christofteuscher/tt-eml-fabric/spice/cell/v3/v3_tran_results.txt

-0.5u 9.37857E-07 9.37859E-07 9.37855E-07
0.5u 5.20401E-07 5.20402E-07 5.204E-07
15u -6.56364E-07 -6.56362E-07 -6.56365E-07
