christofteuscher/tt-eml-fabric/(commit log)

2026-07-30 EML Fabric: analog config + datasheet + cfgdig hardening CI
    Overlays the real project onto the ttsky26c analog template:
    info.yaml 2x2 tile, 3 analog pins, uses_vapwr, top_module
    tt_um_teuscher_eml_fabric; pinout = scan (ui0/1, uo0) +
    ua0 x_in / ua1 mux_out / ua2 iref_in
    docs/info.md datasheet written from measured behaviour
    src/ the wrapper (4 lv->hv scan shifters + macro) and cfgdig RTL
    openlane/cfgdig + .github/workflows/cfgdig.yaml
    LibreLane hardening of the 64-bit config chain -- the extra
    CI job; recipe proven locally over 15 Docker runs (hvl
    corners, PDN, core-area, pin-order, cell-pa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
    [pin_order.cfg]
2026-07-30 Remove pin_order.cfg: it breaks the cfgdig CI harden
    The cfgdig hardening job failed because LibreLane AUTO-RESOLVES a
    pin_order.cfg in the design dir even when IO_PIN_ORDER_CFG is unset, and
    this file's leading '#' comment lines are parsed as malformed side
    directives ("identifier/regex '#' requires a direction to be set first").
    There is no comment syntax in that format. config.json sets
    IO_PIN_ORDER_CFG=None and does not need it, so the file is removed. The
    local 251x36 recipe hardens clean without it.
    [pin_order.cfg]
2026-07-30 Pin cfgdig CI to LibreLane 3.0.5
    The harden ran the full flow (~10 min) then failed: 'nix run
    github:librelane/librelane' was UNPINNED, pulling newer than the 3.0.5
    the config recipe was tuned against over 15 local runs (corner names,
    FP_PDN_MULTILAYER, CELL_PAD_EXCLUDE, MAGIC_CAPTURE_ERRORS, etc. -- all
    3.0.5-specific). 3.1.0.dev builds exist upstream, so unpinned drifted
    ahead. Pinned to the exact local version.
    EOF
2026-07-30 cfgdig CI: ship hvl excluded-cell lists, override the broken PDK default
    With tools now pulled prebuilt from the FOSSI cache, the flow reaches
    PDK load and dies on SYNTH_EXCLUDED_CELL_FILE / PNR_EXCLUDED_CELL_FILE:
    LibreLane 3.0.5 defaults them to libs.tech/librelane/sky130_fd_sc_hvl/
    {synth,pnr}_excluded.cells, but ciel's default PDK rev (8afc834...)
    predates the hvl migration from libs.tech/openlane/no_synth.cells and
    ships neither -> 'path provided is invalid'. hd migrated; hvl did not.
    Ship both lists in the repo (content copied verbatim from the rev the
    local --dockerized runs use, f3c505b) and point the two variables at
    them via dir::, so signoff no longer depends on which PDK rev CI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
2026-07-30 cfgdig CI: patch the missing hvl exclude files into the fetched PDK
    The previous dir:: override was moot: SYNTH_EXCLUDED_CELL_FILE and
    PNR_EXCLUDED_CELL_FILE are validated at PDK-load, against the PDK's own
    declared paths (libs.tech/openlane/sky130_fd_sc_hvl/{no_synth,drc_exclude}
    .cells), which a design-config value cannot reach. Those two files exist
    in the local ~/.ciel tree but ciel's fresh fetch of the pinned rev omits
    them, so PDK load quits before the flow starts.
    Split harden into fetch + repair + harden: the fetch run downloads the
    whole PDK (then fails load, swallowed by || true), the repair step writes
    the two files verbatim into the fetched tree, and harden then loads the
    PDK cl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
2026-07-30 cfgdig CI: restore pin_order.cfg (the docker15 golden input)
    PDK load now clears (hvl excludes patched); the next PDK-load path error
    is IO_PIN_ORDER_CFG -> dir::pin_order.cfg, a file the config referenced
    but the repo lacked. An earlier precautionary removal left the dangling
    reference; CI never actually reached pin-order parsing back then because
    the nix tool build was failing first.
    Restore the exact side assignment the golden docker15 run used (which
    hardened to DRC 0 / LVS MATCH): all fabric-facing config lines South,
    the scan interface North. Descriptive header comments are dropped so the
    file is only directives + escaped-bracket regexes (parser-safe); key
    modernized FP_PIN_ORDER_CFG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
    [pin_order.cfg]
2026-08-06 Add the hardened analog macro; scan_clk moves to ui_in[2]
    GDS + LEF for tt_um_teuscher_eml_fabric, verified on exactly the files
    committed here:
    DRC 0 (sky130A_mr, feol+beol+offgrid), met5 and via4 empty, top cell
    renamed, bbox 0,0..319.24,225.76, LEF SIZE matches the TT DIEAREA.
    The macro is a rename+label of the routed top level -- geometry compared
    layer by layer, all 12 identical in shape count and area, so its LVS
    MATCH carries over.
    Routing: 52/62 nets, 5/5 signal pads, power 21/21, top LVS MATCH.
    Every functional net is connected -- the A->B chain (CELLA.out ->
    link1.glue.nout), all three analog bias rails (sum_Bv, vg4, vgu) and the
    full config scan chain. The 10 remaining opens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
2026-08-06 Fix precheck: full LEF port list, pins on real metal, iref to ua[1]
    Addresses three of the five precheck failures from run 31127339246.
    LEF PIN CHECK (was: 45 errors). gen_ttmacro.py emitted only the 6 pins
    this design uses; TT wants the whole template port list present so the
    harness can bind to it. It now parses tt_analog_2x2_3v3.def and emits
    all 54 -- clk, ena, ui_in[0..7], uio_in/out/oe, uo_out[0..7], ua[0..7],
    rst_n and the 3 power pins.
    PIN LABEL OVERLAPPING DRAWING (was: 4). Two separate causes:
    * the north pad boxes span y224.76-225.76 but the router draws met4
    only to y225.00, so 0.76 um of each pin rect lay over nothing. met4
    drawing is now laid across the full pad bo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
2026-08-06 Power ports: one full-height rect per stripe, not a decomposition
    Precheck on 30b0d12 went 10/15 -> 12/15 (pin-label-overlap and the
    analog pin now pass, LEF pin errors 45 -> 6), but the remaining 6 were
    all mine:
    ERROR: Port VAPWR is too far from bottom edge of module: 82.7 > 10 um
    ERROR: Port VAPWR is too far from top edge of module: 139.46 > 10 um (x3 pairs)
    TT wants a power port to start within 10 um of the bottom edge and reach
    within 10 um of the top. Clipping the stripe to real metal and then
    DECOMPOSING it into 11 rectangles produced mid-die fragments touching
    neither edge -- the previous commit fixed pin-label-overlap and broke
    power-port geometry in the same stroke.
    The s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
2026-08-06 Resistor precision marker on the body only; re-verified with TT's own deck
    VERIFIED LOCALLY BEFORE PUSHING, with the deck TT actually runs. That is
    new: silicon/tools/ttdeck now vendors tt-support-tools' precheck deck
    (release 2025.10.29_01.10, from chipfoundry/mpw_precheck, 1773 lines)
    alongside TT's exact PDK. The PDK's own deck is 2024.2.11_01.09 and 1629
    lines -- running it and calling the result "DRC clean" is what let this
    project report DRC 0 for weeks while precheck found 6 violations.
    tools/ttdrc.sh reproduces the CI number exactly.
    top: 52/62 nets, 5/5 signal pads, DRC 0, LVS MATCH
    TT deck on the submitted macro: feol 6, beol 0, offgrid 0
    THE RESISTOR CHANGE DOES NOT REDUC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
2026-08-07 Revert the resistor rpm change: Magic measured it 626 errors WORSE
    The previous commit moved the precision-resistor marker to the body only.
    KLayout scored that neutral -- 6 FEOL violations either way -- so it went
    out. Magic disagrees, and Magic is also part of precheck:
    30b0d12 (before) 3263 magic errors
    09ad48a (after) 3889 magic errors +626
    Heads left outside rpm abut its boundary at zero distance, and rpm.3 /
    rpm.7 want 0.4 um: +684 and +152, plus 304 rpm.1 and 228 poly.9, against
    ~800 licon ones removed. KLayout's deck does not implement rpm.3, rpm.7,
    poly.9, LU.2/LU.3, nwell.7/8 or capm.11 AT ALL, so tools/ttdrc.sh could
    never have caught this. Reverted; verified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
2026-08-07 Resistor cells + well/tap: Magic 3263 -> 214, KLayout FEOL 6 -> 0
    Measured locally before pushing, with both decks TT actually runs
    (silicon/tools/ttdrc.sh and ttmagic.sh, release 2025.10.29_01.10):
    MAGIC 3263 -> 214 KLAYOUT feol 6 -> 0
    toplevel_routed DRC 0, LVS MATCH, 0 shorts
    ROUTED 52/62, PAD ACCESS 5/5 -- unchanged by any of this
    Gone entirely: all 1034 licon errors, all 288 P+ poly.1a, all 67 LU.3,
    all 46 nwell.8, and the 6 MR_licon.CON.xx that were failing FEOL.
    The previous two attempts at the resistors both failed because they
    changed the cell without paying for it in the blocks. This one does
    both. Root causes, read out of the Magic tech file and the PDK P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
2026-08-07 hvi.5 mechanism found: decaps instead of fillers; Magic 192 -> 60
    Measured locally before pushing, both decks TT actually runs:
    MAGIC 192 -> 60 KLAYOUT feol 0
    toplevel_routed DRC 0, LVS MATCH ROUTED 52/62, PAD ACCESS 5/5
    The hvi.5 wall (161 of the 192) is broken. It was never a spacing
    problem in our drawn geometry: with `gds maskhints yes`, Magic re-derives
    thick oxide from DEVICES at GDS read and keeps only the un-derivable
    remainder of the drawn HVI as "mask hint" fragments -- hvi.5 is
    cifspacing over those fragments, not over the drawn layer. The fragments
    were runs of fill_* cells, which carry HVI but no diffusion; each run's
    HVI survived as a ~40 um hint strip, an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
2026-08-07 mdac_gamma LU.2 fixed; every analog block now Magic 0. Macro 60 -> 48
    MAGIC 60 -> 48 KLAYOUT feol 0
    Every analog block -- bias_core, rptat_trim, refchain, emlcell2,
    chainglue, raildrv, mdac2_alpha_d2, mdac2_gamma_d2 -- is now
    Magic 0 / KLayout 0 / LVS MATCH.
    mdac_gamma's 12 LU.2 had been parked as "the substrate tap breaks LVS"
    after five failed placements. The placements were never the problem: a
    bbox bug in the tap-fill helper. A leg riser's met1 tip pokes 0.05 um
    into the tap band, the free region was correctly notched around it, and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
2026-08-12 Submit the lvshift macro: Magic 0 on the SHIPPED file, 3 analog pins
    Layout, measured on one clean build (silicon 1a42bf8, EXTERNAL_LVSHIFT=1):
    ROUTED 57 / 57
    chk_padaccess 7 CONNECTED, 0 OPEN
    chk_conn 57 nets joined, 0 OPEN
    KLayout top DRC 0
    top LVS MATCH, 16 / 16 circuits
    MAGIC (assembly) 0
    And on the artifact in this commit, which is the one TT prechecks:
    tt_um_teuscher_eml_fabric.gds MAGIC 0, KLayout DRC 0
    tt_um_teuscher_eml_fabric.lef 54 pins, unchanged
    The four PDK level shifters are gone, replaced by the custom all-MV
    lvshift block (five-corner verified), which is what takes Magic to 0.
    The scan nets reach it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
2026-08-12 Restore all template ports; clear met4 spacing by trimming our own wire
    Fixes the precheck failure on 48bd0d0: "Port uo_out[7] missing from layer
    met4.pin", 44 GDS errors. Precheck reads the GDS pin layer, not just the
    LEF, so the previous drop of unused-pin geometry was the wrong trade -- it
    cured 8 met4.2 by removing 44 ports.
    Every template port is drawn again. The met4 spacing clash is resolved by
    trimming the routed wire end 0.08 um at packaging time:
    route ...81.050 -> ...80.970 against the pin box at 81.270
    gap 0.220 -> 0.300, exactly met4.2's minimum
    Verified on this file: Magic 0, KLayout DRC 0, 60 met4.pin shapes, LEF 54
    pins. TT's gds job already passed on the previo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
2026-08-12 Observability: every stage boundary of the chain reaches a pad
    The 2-cell chain was a black box: only the final output was visible, so a
    wrong answer could be CELLA, the gamma coupling or CELLB with nothing to
    tell them apart. The obs mux meant to solve this observed nothing and was
    cut. These are direct taps, like ua[0]/ua[2] already were.
    x_in ──> [CELLA] ──> out_CELLA ──> [gamma] ──> sum_Bv ──> [CELLB] ──> out_CELLB
    ua[3] ua[4] ua[0] ua[2]
    PADS ARE ASSIGNED BY GEOMETRY, NOT PIN NUMBER. The ua pads march west with
    index (ua[0] x=136.62 ... ua[5] x=40.02) while the consumers do not: CELLA
    sits west, CEL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
    [cfgdig.v]
2026-08-12 trim3 removed: the RTL allocated a 4th trim bit the network cannot use
    cfgdig.v declared rtrim[3:0] while rptat_trim has THREE shorting switches,
    so trim3 was a config bit that reached nothing. It surfaced only as an
    OPEN pin ("each is a pin the netlist gives no net") -- DRC, LVS and the
    conductance walk were all clean around it, because a bit that drives
    nothing shorts nothing.
    THE LAYOUT IS THE CORRECT SIDE. bias/rptat_trim.inc is three binary
    segments (1x/2x/4x the 5k unit) over a 15k base:
    R = 15k + (1-t0)*5k + (1-t1)*10k + (1-t2)*20k
    "Eight levels in 5k steps ... coarse ON PURPOSE: this is a range-setter,
    not a precision knob", and its 15-50k span already covers the measured
    po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
    [cfgdig.v]
2026-08-12 docs: the bringup guide described a chip that no longer exists
    info.md would have sent someone to the wrong pads. Every one of these
    was stale, and the pin errors are the kind you only discover with a
    probe on the bench:
    scan chain 64 bits -> 29. Weights are [24:0] (five, not eleven),
    trim is [27:25] (not [61:58]), tail [28].
    x_in ua[0] -> ua[3].
    scan_clk ui[1] -> ui[2]. ui[1] sits off the analog macro's 0.6 um
    routing grid so no via can be placed beside it -- this one
    has been true for a while and was never written down.
    obs mux documented with 8 channels and a mux_out on ua[1]; the
    block was removed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
2026-08-12 docs: quantify the weight monotonicity margin (70 MC samples)
    The monotonicity note previously cited 30 samples. Extended to 70:
    0/70 non-monotonic, per-sample worst DNL mean -0.276 sigma 0.190 LSB,
    worst observed -0.981 against the -1.0 limit.
    Stated the limit as ~3.8 sigma AND why that number should not be read as
    1-in-14000: -0.981 appeared once in 70 samples where a clean Gaussian at
    that sigma puts it near 1 in 3800, so the tail is heavier than normal and
    the Gaussian extrapolation understates the risk. 70 samples cannot
    resolve a 1e-4 tail in either direction. What is established: no sample
    was non-monotonic, and the margin is real but not large.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
2026-08-13 docs: record the measured ln deficit -- the chip computes exp(u) - 0.34*ln(v)
    Measured 2026-08-12, the first v-sweep in the project. The
    characterisation always held v=1, which zeroes the ln term, so this was
    never visible.
    ideal -1.000
    schematic -0.696 idealised OTAs, perfect bias
    silicon -0.342
    Root cause is servo gain: nva should be pinned to vrefb and drifts ~17 mV,
    so most of the transdiode differential that should drive R_LN shows up as
    servo input error instead. DESIGN-LEVEL, not layout or process -- the
    schematic with ideal sources is already 30% short, so a single 5T stage
    never had the gain a translinear loop needs.
    The exp path is unaffected and beh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
2026-08-13 Correct the exp path: resistors were sized without end resistance
    The poly resistors were sized by L/W x rsheet, which ignores END
    RESISTANCE -- effective sheet is 393 ohm/sq against a nominal 317.4, so
    res_5k measured +37% and res_13k45 +27%. RU/RLN are 4x res_13k45, which
    made the cell compute exp(1.23*u) instead of exp(u).
    Measured on the layout-matched netlist: exponent k 1.224 -> 0.961.
    Verified on THIS macro: 57/57 routed, pad access 9/9, power 23/23,
    top DRC 0, top LVS MATCH, Magic 0, 60 met4.pin shapes, and the resistor
    markers in the assembled GDS read 3.79 / 11.44 / 17.5 (were 5.47 / 14.72
    / 17.5).
    A second bug surfaced during the rebuild and is also fixed: a hardcoded
    copy of t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
2026-08-13 Back to 3 analog pins -- only 3 were purchased
    analog_pins was raised 3 -> 5 on 2026-08-12 to add observability taps on
    out_CELLA and sum_Bv. The TT template says "valid values 0 to 6" and I
    treated that as permission; only THREE were bought for this shuttle, so
    5 is not submittable.
    PRECHECK DID NOT CATCH IT. a4a231d passed CI including precheck, because
    precheck validates that DECLARED pins are CONNECTED -- not that you own
    them. A green check that did not mean what it appeared to.
    Reverted to the pre-observability arrangement, which is also the one whose
    routing is proven (it shipped as 9d37a59):
    ua[0] x_in | ua[1] iref | ua[2] out_CELLB
    TT wires ua[0..analog_pins-1], so the used pi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
2026-08-13 docs: add a block diagram and the source paper reference
    Diagram shows the actual signal path -- x_in -> CELL A -> glue -> gamma
    MDAC -> CELL B -> out_CELLB -- with the bias core, the trim network and
    the scan chain feeding the five weights, and the pin each edge lands on.
    Reference is the real citation, taken from the PDF rather than
    reconstructed: A. Odrzywolek, "All elementary functions from a single
    operator", Jagiellonian University, arXiv:2603.21852v2 [cs.SC],
    4 Apr 2026. Includes the operator definition, two of the papers own
    constructions (e^x = eml(x,1), ln x = eml(1,eml(eml(1,x),1))) and the
    grammar S -> 1 | eml(S,S), plus a sentence on what this chip is in
    relation to it: a hardw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
2026-08-13 Fix the ln path: source-follower buffer on the servo output
    The cell now computes exp(u) - ln(v). Previously the ln term was not a
    logarithm at all: a least-squares fit gave -0.34*ln(v), but that was only
    the AVERAGE slope of a curve whose local slope ran -0.12 to -0.65 across
    the input range. A 5.5x variation cannot be calibrated out -- k*ln(v) =
    ln(v^k) only inverts for a constant k -- so the v input was not usable for
    quantitative work.
    Cause: the servo output drove the transdiode base directly, and that base
    (r_pi ~1.5 Mohm at beta ~29) collapsed the servo open-loop gain from 112 to
    3.2. The servo could not hold the transdiode collector still, so the two
    legs sat at different V_BC an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
2026-08-14 docs: the ln argument is (v+1.87)/2.79, not v -- correcting a wrong figure
    The cell computes ln((v+1.87)/2.79). Measured on emlcell_b_sim14_buf.inc,
    derived from lvsref/emlcell_b_flat.spice which LVS-matches the shipped
    layout, tt 27C, v = 0.5..4:
    fitted vs ln(v+1.74): 2.10 - 1.005*ln(v+1.74) max resid 0.0002 units
    fitted vs ln(v): 1.04 - 0.454*ln(v) max resid 0.072 units
    As a log amplifier the cell is close to ideal against its true argument.
    Only the argument is offset. The layout hard-wires a bias pedestal the
    schematic bench never modelled: XLPA puts 936 nA (1.872 units) on the nv
    transdiode and the reference leg XLPB_LVR carries 1394 nA (2.789 units), so
    the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
2026-08-14 Revert the source-follower buffer: it made the servo loop unstable
    Restores gds/ to a8f1948. LEF and RTL are unchanged (the LEF was already
    byte-identical between the two builds).
    WHY. 52c7494 added a source follower (MSF, W16 L1) plus a 0.5 uA sink
    (MBM, W4 L8) to each ln servo, to fix an apparent slope error. Two things
    were wrong with that.
    1. THE SLOPE ERROR WAS NOT REAL. It came from fitting the cell against
    ln(v) when the die's argument is offset. Fitted against its true
    argument over v = 0.5..4 on the layout-matched netlist:
    unbuffered (this build): 2.549 - 1.145*ln(v + 2.574) resid 0.00023
    buffered (52c7494): 2.101 - 1.005*ln(v + 1.741) resid 0.00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
2026-08-14 docs: exp coefficient is 0.927 on the die, not 0.96
    Re-derived on the layout-matched netlist emlcell_b_sim12.inc rather than a
    schematic bench, since the ln figure had already proved wrong for exactly
    that reason. tt 27C, u = -1..+1.25, v held at 1:
    io = 1.101 * exp(0.927*u) - 0.010 max residual 0.0004 units
    Unlike the ln case this one holds up: it is a clean exponential, residual
    four ten-thousandths of a unit. The coefficient drifts mildly across the
    range (0.931 at u=+0.6 to 0.955 at u=-1.25). The previous 0.96 came from a
    bench and was ~3.5% optimistic; the qualitative claim was right.
    Note on method: the harness inverts u (the TIA inverts), so driving IUIN
    with +u gives a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
2026-08-14 docs: publish the 24% per-cell level spread and the temperature window
    Two measured limits that govern how the part must be used, neither of which
    the documentation mentioned.
    PER-CELL LEVEL SPREAD, 24.3% at 1 sigma. 440 Monte Carlo samples of the
    layout-matched netlist, io at v=1 u=0: mean 1.098 units, sigma 0.266, range
    0.446..1.838. Peak-to-peak is 1.27x the nominal output. Mismatch-limited
    rather than process-limited (tt_mm alone gives the full 24.3%; the skew
    corners add nothing), so it does NOT average out across the fabric -- each
    cell draws independently. The shape is unaffected: under full mismatch the
    log and antilog fits still hold to ~2.5e-4 and ~3.2e-4 units, i.e. mismatch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
2026-08-14 docs: correct ln/exp coefficients for resistor segmentation (+4%)
    The layout draws RU and RLN as FOUR series bodies of L=11.44 um; every
    simulation netlist and LVS reference lumps each as one L=45.76 um device.
    They are not the same resistor -- each body carries its own ~741 ohm of end
    resistance, so 4 x 11.44 measures 53.75 kohm against 51.53 kohm for the
    lump, +4.31%.
    Simulating the segmented form on the shipped cell:
    ln 2.549 - 1.145*ln(v+2.574) -> 2.478 - 1.094*ln(v+2.547)
    exp 1.101*exp(0.927*u) - 0.010 -> 1.101*exp(0.967*u) - 0.009
    Both move ~4% CLOSER to ideal, so the part is better than we were
    publishing: ln slope error 14.5% -> 9.4%, exp coefficient error 7.3% ->
    3.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
2026-08-17 docs: bias tolerance, output loading and PSRR
    Three measured operating limits the documentation did not carry, one of
    which bring-up needs before touching the trim.
    BIAS CURRENT is the tightest constraint. The reference sets BOTH transfer
    coefficients -- they are properties of the bias, not the topology: scaling
    the bias generator gives exp coefficient B = 1.853 x I[uA], constant to
    0.5%, with the ln slope moving inversely. Varying pbias alone, a -30% error
    (0.35 uA) already clips the top of the input range: the output crosses zero
    at v ~ 3.4 and goes negative beyond. At 0.25 uA the crossing is v ~ 1.8.
    Nominal 0.5 uA sits at the LOW EDGE of the range that keeps v = 0.25..4
    usable. Above no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
2026-08-17 docs: 10 ms power-up hold, and the bias core characterisation
    First characterisation of the on-chip PTAT bias core. Nothing had ever
    measured it, and the cell's transfer function is set by its bias current
    rather than by its topology, so this was the largest unverified risk on the
    part.
    THE BRING-UP ITEM: wait at least 10 ms after power-up before reading. The
    start-up escape path is 5.5 pA and junction-leakage limited, so it is slow
    exactly where leakage is small: simulated at ss / -40 C the core is still in
    its degenerate zero-current state at 1 ms and wakes between 1 ms and 10 ms.
    At tt / 27 C it is up in microseconds, so a warm bench will never show this.
    A cold part read too early looks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
2026-08-17 lef: fix pin directions -- TT rejected uio_in as INOUT
    TT submission failed with: Invalid LEF file: Pin uio_in[0] has direction
    INOUT, expected INPUT.
    gen_ttmacro.py:141 grouped ua and uio together:
    INOUT if defpin.startswith((ua,uio)) else
    (OUTPUT if defpin.startswith(uo) else INPUT)
    so all 24 uio_* pins came out INOUT. Only the ANALOG pins are genuinely
    bidirectional. Order also matters: uio must be tested before uo, or
    uio_out/uio_oe fall through to the uo branch.
    Now emitted by pin class:
    INOUT 11 ua[0..7] + VAPWR/VDPWR/VGND
    INPUT 19 ui_in[0..7] + uio_in[0..7] + clk, ena, rst_n
    OUTPUT 24 uo_out[0..7] + uio_out[0..7] + uio_oe[0..7]
    total 54 pins
    THE GDS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
2026-08-17 docs: correct the mismatch caveat -- tt_mm excludes process, not mismatch
    An earlier revision claimed sky130's tt_mm varies MOSFETs only, that the
    resistor models carry no statistical terms and NPN mismatch is an inactive
    comment, and that the 1.75% bias-core sigma was therefore optimistic. All of
    that is wrong. Checked against the model files:
    res_high_po_0p35 res_match = {(body_pelgrom/sqrt(w*l*mult))
    *MC_MM_SWITCH*AGAUSS(0,1.0,1)}
    npn_05v5_W1p00L1p00 is = '... + MC_MM_SWITCH*AGAUSS(0,1.0,1)
    *(...*0.00473/sqrt(mult))'
    bf = '... + MC_MM_SWITCH*AGAUSS(0,1.0,1)
    *(...*0.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
2026-09-08 Add the simulation code and SPICE decks behind the npj/ICRC paper
    The repository held the layout and generators but not the software or
    circuit-level artifacts the paper's numbers come from, and the Data
    availability statement said so. It now holds both.
    sim/ the differentiable network model, the benchmark harness, the
    expression-corpus enumerator, the energy analysis that produces
    the composability overhead and the 72-corner sensitivity box,
    the derived datasets and the fixed-seed regression tests.
    spice/ the ngspice decks, the cell and chain netlists, and the
    post-layout extractions carrying parasitic R and coupling C.
    The decks are commit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
    [cell_u_v0.2.csv, cell_u_v1.0.csv, cell_u_v5.0.csv, cell_vsweep.csv, chain_full.csv, chain_out.csv, glue_ped_L2.csv, glue_ped_L8.csv]
2026-09-17 Add CITATION.cff so the Cite button points at the paper
    preferred-citation sends GitHub Zenodo and Zotero to arXiv:2609.17903
    rather than to a citation for this repository.
2026-11-06 Revision 1 artifacts: wake-up decks, exact corpus enumerator, MLP check
    spice/char/wakeup: decks, re-extracted cell netlist, analysis scripts and
    gzipped waveforms of the wake-up and power-gating study (paper Results 2.5,
    Table 5). Decks use $PDK_ROOT; base_pex reproduces 401.9 ns / 40.4 pJ.
    sim/corpus: the grammar enumerator in exact arithmetic, with its outputs.
    sim/ml/check_osc_prod.py: the sin(2 pi x1 x2) rerun cited in the response.
    Claude-Session: https://claude.ai/code/session_013rzTj4Hgwn1w4vdmDJmRLN
